rfidtool/ESP-RFID-Tool/Connector-Adapter-Options/README.md

## Connector Options  
  
### Standard Screwdown Connection  
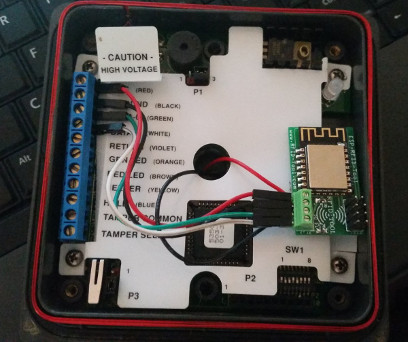
[picture p3: Connector-Adapter-Options/screwdown.jpg]
ScrewDown
  
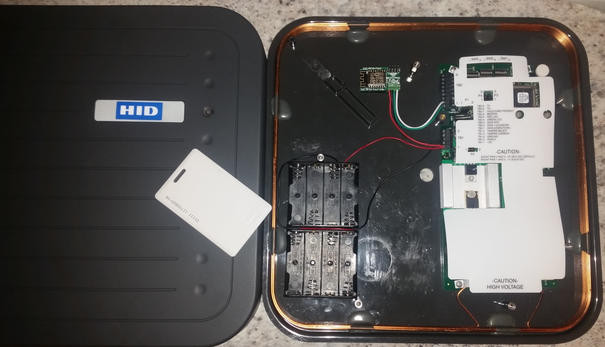
[picture p4: Connector-Adapter-Options/portable-5375.jpg]
ScrewDown-Portable-5375
  
  
### Gray Wire Nuts 22-16AWG  
  
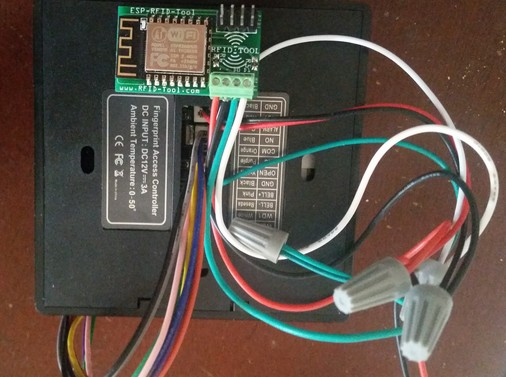
[picture p5: Connector-Adapter-Options/wirenuts.jpg]
Wire-Nuts
  
##### Note: For 24AWG you need to twist the wires and fold them over once to obtain a secure connection or use smaller wire nuts(They make a 24-18AWG which is perfect but color varies).  Gray Wire Nuts are common though and can be found in most hardware stores.  
  
### Screwdown to T-Taps (Wire Splices)  
  
#### T-Tap Example 1  
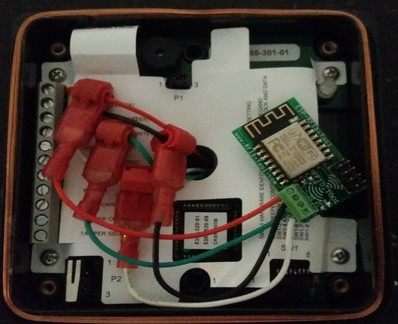
[picture p6: Connector-Adapter-Options/tsplice1.jpg]
T-Tap1
  
* Uxcell T-Tap Male Insulated Wire Terminal Quick Connector Combo Set 10 Piece, Red  
  * by Uxcell  
[$6.82 on Amazon](http://a.co/6joYNzS)  
##### Note: These may require a light squeeze on the connector with pliers to cut past the insulation properly. Links are not suggested brands but simply examples.  
  
#### T-Tap Example 2  
* Brightfour Quick Wire Splice Connector-T type 1 Pin solderless- Compatible with 22 - 20 AWG Cable for Some Tight-fitting Automotive Uses  
  * by Brightfour  
[$8.44 on Amazon](http://a.co/bAw7Fdw)  
##### Note: These may require a light squeeze on the connector with pliers to cut past the insulation properly. Links are not suggested brands but simply examples.  
  
### Screwdown to Punchdown Adapter  
  
##### PCB renders generated using https://pcbs.io.  
  
#### Side by Side  
 * [Gerber File](Punchdown-Adapter-1/punchdown-adapter-Gerber.zip)  
 * [BOM File](Punchdown-Adapter-1/BOM)  
 * [Order PCB](https://pcbs.io/share/4KXmA)  
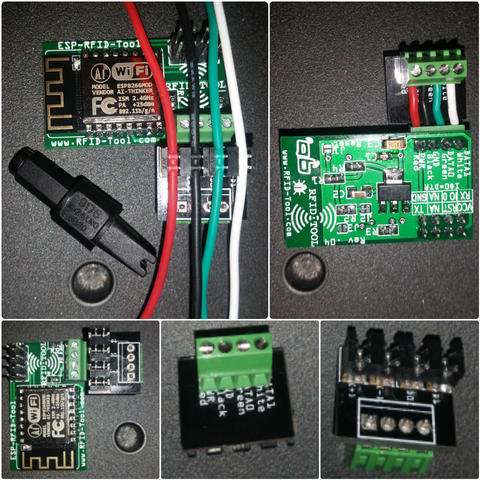
[picture p7: Connector-Adapter-Options/punchdown.jpg]
Punchdown1
  
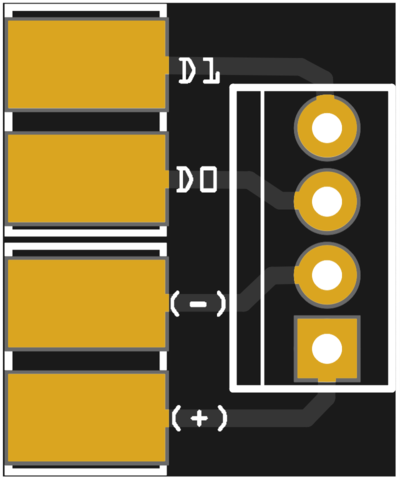
[picture p8: Connector-Adapter-Options/Punchdown-Adapter-1/top-adapter.png]
Punchdown1-top
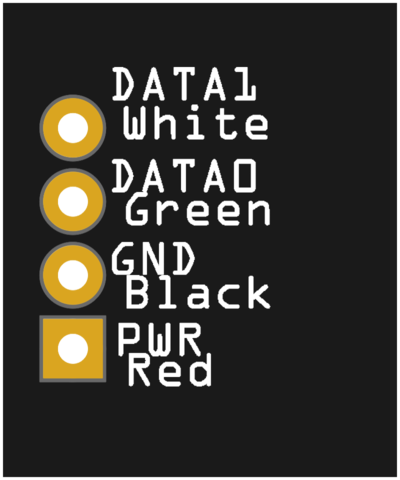
[picture p9: Connector-Adapter-Options/Punchdown-Adapter-1/bottom-adapter.png]
Punchdown1-bottom
   
  
#### Perpendicular  
 * [Gerber File](Punchdown-Adapter-2/punchdown-adapter2-Gerber.zip)  
 * [BOM File](Punchdown-Adapter-2/BOM)  
 * [Order PCB](https://pcbs.io/share/zy0jg)  
The image pictured below is a custom build with the programming header removed, and the screwdown block replaced by a 4 pin header which was soldered in place and then broken off once the adapter was added on. I easily performed all of these modifications by hand using both a soldering iron and hot air rework station.  
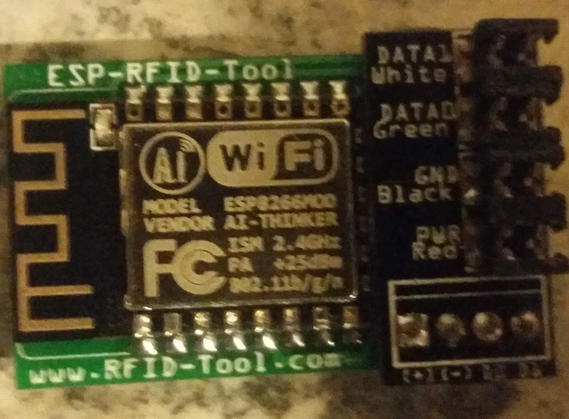
[picture p10: Connector-Adapter-Options/pd2-custom.jpg]
Punchdown2-Custom
  
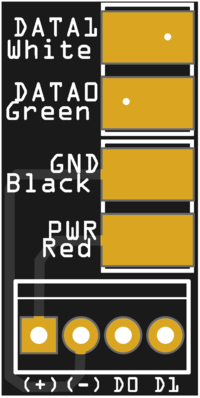
[picture p11: Connector-Adapter-Options/Punchdown-Adapter-2/top-adapter2.png]
Punchdown2-top
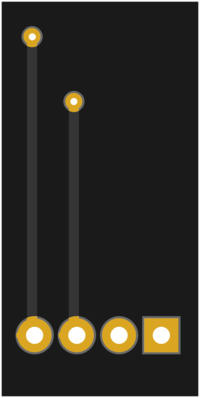
[picture p12: Connector-Adapter-Options/Punchdown-Adapter-2/bottom-adapter2.png]
Punchdown2-bottom
