rfidtool/ESP-RFID-Tool/Images/README.md

  
Board  
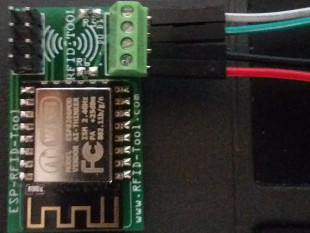
[picture p13: Images/wiring.jpg]
Wiring
  
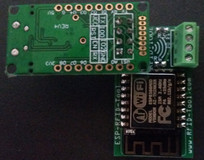
[picture p14: Images/programmer.jpg]
Programmer
