rfidtool/ESP-RFID-Tool/Keypad/README.md

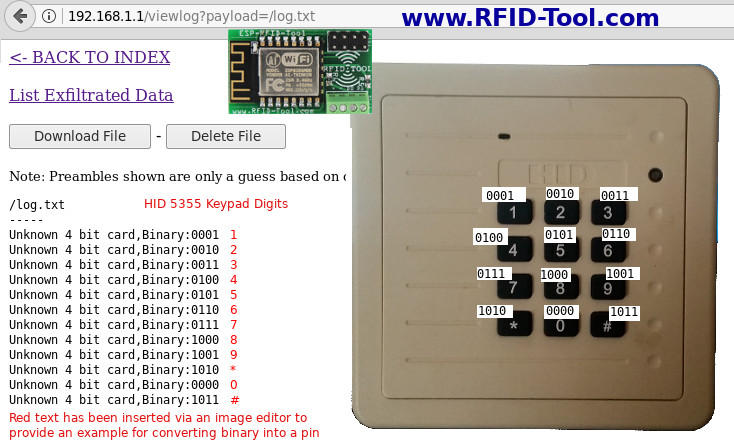
[picture p15: Images/5355keypad-bin2pin.jpg]
HID-5355-Bin2Pin-Reference
