rfidtool/ESP-RFID-Tool/Images/webint.png

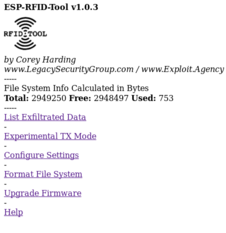
Images/webint.png
