rfidtool/ESP-RFID-Tool/Installation-Schematics/README.md

Implant  
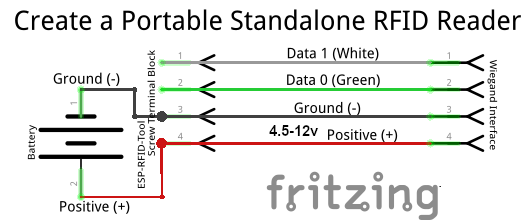
[picture p17: Installation-Schematics/portable-standalone.png]
Portable-Standalone
  
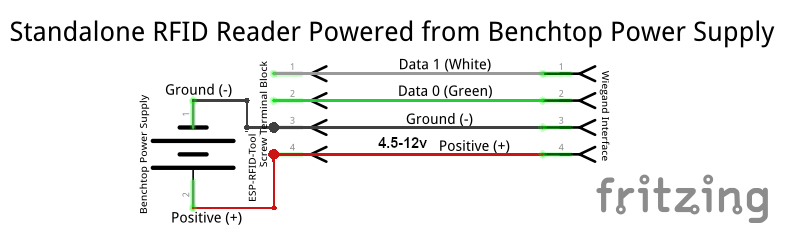
[picture p18: Installation-Schematics/benchtop-psu.png]
Benchtop-PSU-Standalone
  
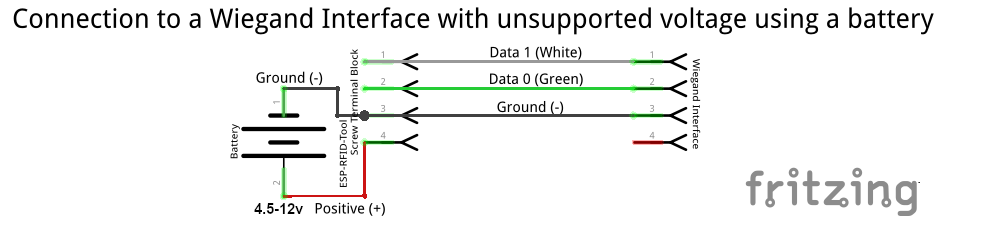
[picture p19: Installation-Schematics/unsupported-voltages.png]
Unsupported-Voltages
  
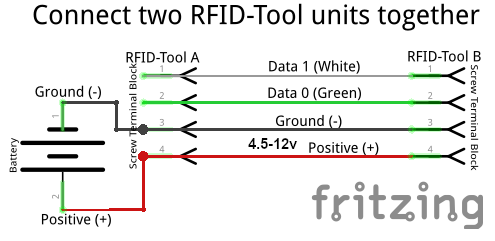
[picture p20: Installation-Schematics/2-rfid-tool-units.png]
2-RFID-Tool-Units
