rfidtool/ESP-RFID-Tool/(threads)

Thread 2 (2018-07-18):

Questions about replay attacks

moliata, 2018-07-18:
Hello,
Is ESP RFID Tool able to replay or clone 13.56 MHz and 125 kHz RFID cards/tokens? Or it's used for different things. I am interested into buying one if so.
Best regards,
Ben.

exploitagency, 2018-07-19:
It depends on the configuration.

When rfid tool is setup inside a battery operated standalone rfid reader it logs card data that may be cloned later to a physical tag using an additional device.

When rfid tool is implanted inside a rfid reader that is part of an actual facility(as in the rfid reader is connected to a wiegand controller) then yes you can both capture and replay card values through the wiegand interface.

moliata, 2018-07-19:
Okay, thanks for letting know.

Closed 2018-07-19.

Thread 5 (2019-10-29):

192.168.4.1 filenotfound after update

gratefuldeadbolt, 2019-10-29:
I am new to the ESPKEY.
Initial setup via 192.168.1.1 went good. Scanned a few cards successfully. I tried to load the latest firmware but after reboot, the device creates an access point ESPKey-xxxxxx where x=mac and this time up address 192.168.4.100
When I try to open the index at 192.168.4.1
I get a window that says "file not found"

Question - How do I reload a good config as a reset or default only loads the config I updated.

Do I need a programming device connected via serial to reflash?

Thankyou

Closed 2019-10-30.

Thread 9 (2021-11-09):

Started burning at 18V

alfonsrv, 2021-11-09:
See title. I'm assuming the module that started burning is the step-down converter. Had 3x4 battery packs connected in series.

Board gets quite hot overall even when running with 12V - probably due to the WiFi module and the small board not being able to dissipate heat.

Just wanted to bring it up, as I think it should be mentioned in the README.md - in case someone plans to build this to carry in e.g. their backpack.

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

exploitagency, 2022-01-29:
I just saw this issue and I am so sorry this happened to you.  It could have been due to the batteries that you chose when fully charged are actually higher than the nominal voltage.  Lets say that they actually read 1.65v fully charged, well that additional .15v multiplied by your 12 batteries would mean an extra 1.8v input and you may have actually been running the voltage regulator with an input voltage of 19.8 volts and the 18v was an ABSOLUTE MAXIMUM.  My prototype I designed could handle up to 24v but there was no benefit in range that I could notice when running the reader at those higher voltages.  In the future go as low as possible.

Regardless what the issue may have been thank you very much for bringing this to my attention and I have added a safety warning and downgraded the maximum voltage rating to 12v to hopefully prevent this from happening again with notes that adding a heatsink to the voltage regulator would be a good idea and to aim for even lower voltages.  But hackers are going to hack and abuse the specs just like this device actually should technically use level shifters but it works without them so it was created to use as few components as possible in that spirit.

> SAFETY: It has come to my attention that the voltage regulator used on the commercially available units that you may find for sale is different than the voltage regulator I originally chose for this project. Also due to global chip shortages and the possibility of manufacturers substituting components I am downgrading the absolute maximum voltage rating to 12v as in you may be stressing the unit to its limits at this voltage and extra care should be taken. Most of my smaller portable prototypes ran at around 9v(x6 AA Batteries) and I found this to be more than adequate, remember that you can always power your reader and the RFID-Tool unit separately if needed and I suggest supplying your project with the lowest possible voltage that you can get away with. In fact, I have found multiple readers that run just fine at less than the recommended voltage. Note that I did not notice a significant range increase in my original testing between supplying 12v and 24v to my reader(I do not recommend this as I tend to abuse the specs for what I am testing, and I was using a different voltage regulator in my prototype). Also be advised that most commonly used batteries produce more than the commonly stated nominal voltage at a full charge. It may also be a good idea to apply a heatsink to your voltage regulator especially if you notice that the unit runs hot at your chosen voltage. It is also never recommended to leave your device unattended. Please be safe and take all necessary safety precautions when testing your setup.

SufficientRole6246, 2023-05-16:
Also, I would be interested in replacing the voltage regulator on my device and seeing if it still works. Can you point me in the direction of the correct component to purchase?
Thanks

exploitagency, 2023-05-16:
I hate to hear that and am sorry that it happened to you. Was it ever attached to higher voltage?

Below is the part for the voltage regulator that was used in the prototype.

Voltage Regulator LM1117 voltage 3.3V out; current 800mA; package sot223; Mouser Part # 926-LM1117MPX3.3NOPB

Also using a low amperage fuse on at minimum the positive Vin line is highly recommended, using a fuse on every line including data shouldn't hurt anything and could help protect connected equipment. I will try to update the schematics soon to include the addition of an inline fuse as well as go through the pull requests.

SufficientRole6246, 2023-05-16:
Thanks for the update.
Re the schematic - I feel like I looked thru the repo here for said document but I could not find it. Am I blind haha?

AFAIK not attached to a higher voltage. At one time it was mistakenly attached to the data lines hooked up to an REX motion sensor. I will make a note to check the voltage on those lines.

Another question for you - I have been searching around for answers and not finding anyone who knows enough. I have been playing with the device on an HID ProxPro and an ICT Vario Prox reader. The HID puts out understandable data. However the same device hooked up to the Vario is spitting out what appears to be random data. Eg one card from the HID reader puts out
26 bit card,18 bit preamble,Binary:000000100000000001 01000010110001001001000101,HEX:2005B1245
and this was confirmed with a Proxmark3
However the same card, run 2x with the Vario puts out
30 bit card,14 bit preamble,Binary:00000010000001 010000110110001001000100000101,HEX:2050D89105
33 bit card,11 bit preamble,Binary:00000010001 011000000101110000100010010000101,HEX:22C0B84485

and I can't seem to make sense of either scan. Same deal with various other cards, puts out understandable data from the HID confirmed with the Proxmark and then gibberish with the Vario. Any direction you can point me in?

Einstein2150, 2024-03-01:
Same here. 13,8V input has something done with the voltage regulator. At the moment all pins of the regulator are shorted. I desolder it and check if the ESP is booting when I direct connect 3.3V to the Vin of the ESP. I hope he is still alive. If he is alive I will try to change it with this part: [https://www.amazon.de/gp/product/B079Q4CH6N/ref=ox_sc_act_title_1?smid=A19GSHTT314PS3&psc=1](https://www.amazon.de/gp/product/B079Q4CH6N/ref=ox_sc_act_title_1?smid=A19GSHTT314PS3&psc=1) otherwise I have to change and refresh the whole ESP too ... :-/

Einstein2150, 2024-03-05:
> Same here. 13,8V input has something done with the voltage regulator. At the moment all pins of the regulator are shorted. I desolder it and check if the ESP is booting when I direct connect 3.3V to the Vin of the ESP. I hope he is still alive. If he is alive I will try to change it with this part: [https://www.amazon.de/gp/product/B079Q4CH6N/ref=ox_sc_act_title_1?smid=A19GSHTT314PS3&psc=1](https://www.amazon.de/gp/product/B079Q4CH6N/ref=ox_sc_act_title_1?smid=A19GSHTT314PS3&psc=1) otherwise I have to change and reflash the whole ESP too ... :-/
>
>

Update: ESP is death too :-/

Thread 12 (2023-01-02):

Unable to flash self-compiled source

shellster, 2023-01-02:
Hi, I am attempting to test some modifications to the code (will PR when ready).  However, I have been unable to get any image that I compile to run successfully.  When I compile even master (unchanged) from this repo, the resulting flash attempt results in a "bricked" RFID Tool.  I can use esptool.py to flash the last release bin and it works without issue.  I assume the settings in my Arduino IDE are not accurate, but in spite of tweaking these settings a bunch of times, I can't seem to get something that works.  Was hoping you could provide more information on what settings you are using to compile the official releases.  I'm currently using Arduino IDE 1.8.15.  I am using the board definition "NodeMCU 1.0 (ESP-12E Module)" from `https://arduino.esp8266.com/stable/package_esp8266com_index.json`.

Leaving all other settings as default (though I've also tried tweaking the FS/OTA settings).

One thing I've noticed, the last official bin from this repo looks like this when I look at the image with esptool.py:

```
python esptool.py image_info esprfidtool.bin
esptool.py v3.0
Image version: 1
Entry point: 4010f29c
1 segments

Segment 1: len 0x00568 load 0x4010f000 file_offs 0x00000008 []
Checksum: 2d (valid)
```

Whenever I generate an image it has two segments:

```
python esptool.py image_info esprfidtool.ino.nodemcu.bin
esptool.py v3.0
Image version: 1
Entry point: 4010f494
2 segments

Segment 1: len 0x00d84 load 0x4010f000 file_offs 0x00000008 []
Segment 2: len 0x00028 load 0x3fff20b8 file_offs 0x00000d94 [DRAM]
Checksum: c9 (valid)
```

shellster, 2023-01-04:
Issue is the need to annotate interrupt handlers with `ICACHE_RAM_ATTR` these days.  I'll add to my PR

Closed 2023-01-04.

Thread 16 (2023-05-25):

Latest build generates random data constantly

edlovesiraq, 2023-05-25:
I've used this in the past and in the initial out of the box setting (1.02 I think) it works like a champ. When I upgrade to firmware 1.21 I get constant random data in the logs. Anyone else have this issue?

Myppomeu, 2024-01-08:
Didn't test it first, just flashed to 1.21 and found trash in logs (wrong bin data). It persists even if device rolled back to 1.02.
@edlovesiraq did you solve the issue?

PDubSec, 2024-01-19:
Same issue for me 1.21 fills the log with garbage data.

Thread 20 (2024-08-09):

QUESTION: Update design to ESP32 to reduce cost, and increase performance?

iWhacko, 2024-08-09:
Hi, since the ESP32's are so cheap now, I think updating the design to that would improve speed and price. Whats your idea on that?

caden-parajuli, 2024-11-16:
This repository hasn't had a code update since 2018, and the creator hasn't made a commit on GitHub in a year, so it seems effectively dead. I just started (as in within the last few days) working on my own project that aims to do essentially the same thing as this project, but based on an ESP32-C2 module with ESP-IDF instead of Arduino. I can post a link if/when I make it public.
