rfidtool/ESP-RFID-Tool/(commit log)

2018-01-03 Add Installation-Schematics
2018-01-04 Add Additional Scenario to Installation Schematics
    Connect two RFID-Tool units together for testing TX and RX, simulations, etc.
2018-01-10 Modify Images/Reference Material
2018-01-10 Add Connectors Folder
2018-01-14 Update Connector Options
2018-02-04 Add Reference Material
2018-02-04 Update Reference Material
2018-02-11 Update aba-decode.php
    For converting track 2 aba binary data to ascii
2018-02-11 Release 1.0.6 - Add Magstripe Decode Link
    Decode Track 2 ABA
    Set Default Buffer to 256bit
2018-02-12 Release 1.0.8 - Improved Magstripe Decoding
    of ABA Track 2
2018-03-02 Release 1.0.9 - Allow control of Experimental TX Timings
    NOTE: Output is 3V3 and may not properly trigger all Wiegand controllers expecting a 5V input
2018-03-04 Update Connector Options Readme
    Add punchdown image
2018-03-05 Update Images
    Add portable 5375 example using screwdown block to connector options page
2018-03-05 Update Connector Options Readme
    Include an example image of a custom hardware modification using the perpendicular punchdown adapter # 2
2018-03-10 Release 1.1.0 - Add PIN TX, Toggle SafeMode, Transition to esp2.4.1 pkg
    * ADD Allow entering a numeric pin directly into Experimental TX Mode
    * ADD allow disabling automatic restarts on captures(Called disabling safe mode)
    * Transition to esp8266 2.4.1 board manager package
    * esp8266 board package 2.4.1 has some bug fixes but still isn't 100% stable, I suggest leaving safe mode on(default)
    [esprfidtool.ino, pinSEND.h]
2018-03-11 Release 1.1.1 - Add Bruteforcing of PIN codes
2018-03-11 Release v1.1.1337 - Fix bug where leading 0's not displayed
    Leading zeros were transmitted properly but not displayed on the initial landing page.
    [esprfidtool.ino]
2018-03-12 Release 1.1.3 - PIN brute force mode ADD advanced delay options
    * Delay between entering complete PINs
    * Number of failed PIN attempts(X) before a delay
    * Delay in seconds(Y) after [X] failed PINs
    * Multiply delay [Y] by [a] after every [b] failed pin attempts
    [esprfidtool.ino]
2018-03-14 Improve Stability and Default to Disable Safe Mode
    [esprfidtool.ino]
2018-03-14 Release v1.1.4
    * Improve Stability
    * Safe Mode Disabled by Default
    * Add Hex2Bin on Data Conversion Tools Page
    [esprfidtool.ino]
2018-03-18 Add (F1) and (F2) keys to PIN related functions
    Available in both RX and TX mode
2018-03-18 Release 1.1.7 - Add (F1) and (F2) keys to PIN related functions
    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
2018-03-18 Update PIN RX Output
2018-03-18 Update API v1.0.1
    to....fix bad typo
    [api.h, esprfidtool.ino]
2018-03-24 API 1.0.3
    * Add the ability to TX multiple "packets"
    * NOTE: Processing multiple packets is limited by the devices RAM
2018-03-25 Release 1.2.1 - Add TX Mode to API 1.0.4
    * Add TX mode to API
    * Fine tune TX data interval now that setting is in microseconds(via API only)
    * TX multiple packets(limited by devices RAM)
    * TX directly from log file view
2022-01-29 Lower voltage rating
